marouane-daoudi/phmetre-numerique/capture_écran/PH_metre_2.PNG

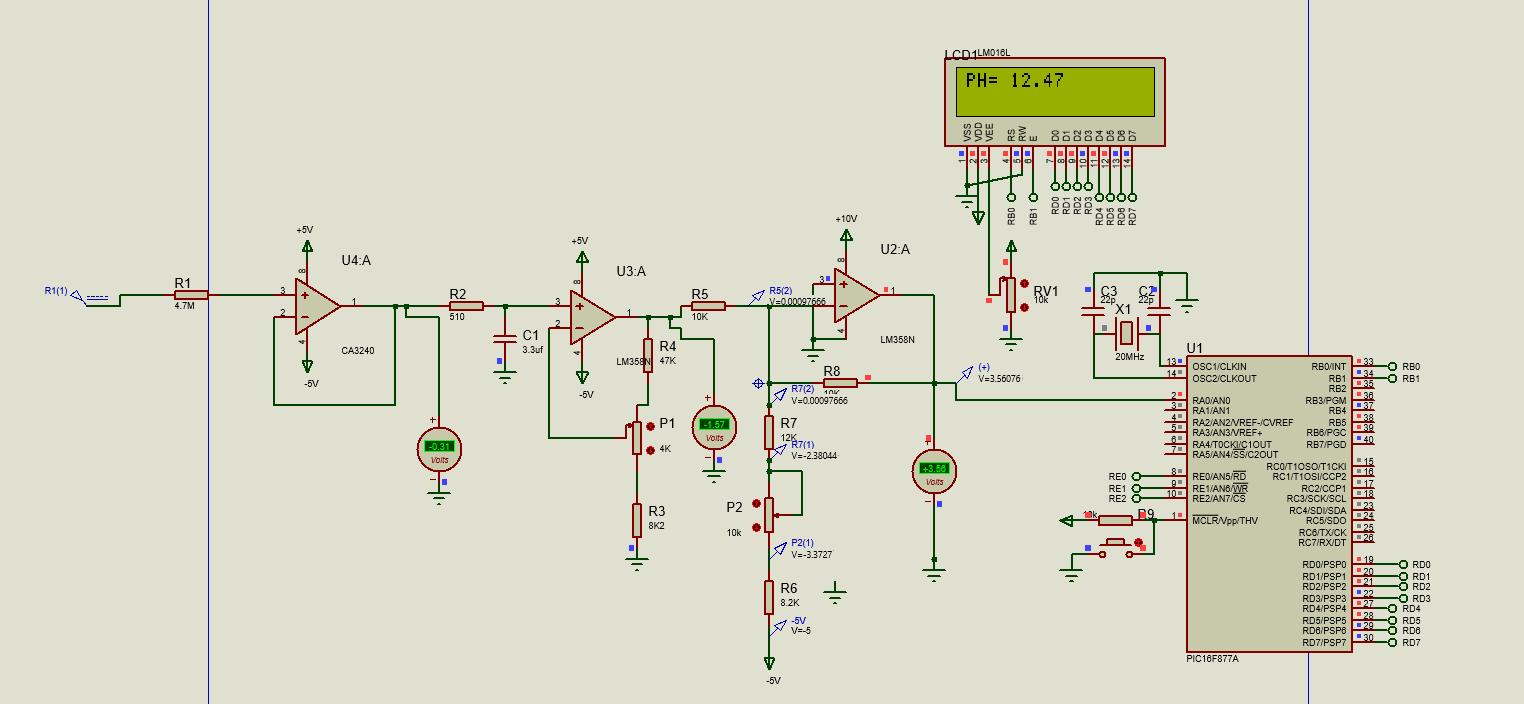
capture_écran/PH_metre_2.PNG
