marouane-daoudi/phmetre-numerique/(list of files, drawings)

Other design files:
phmetre_numerique_simulation.pdsprj
